jakeson21/tac5212-breakout/README.md

# tac5212_breakout
Breakout board for TAC5212
