jakeson21/tac5212-breakout/docs/Audio 2025_10_05.xlsx

Index | Manufacturer Part Number | Attrition % | Requested Quantity 1 | Pack Quantity 1 | Pack Type 1 | Digi-Key Part Number 1 | Unit Price 1 | Extended Price 1 | Minimum Order Quantity 1 | Product Notes
1 | IM69D128SV01XTMA1 |  | 2 | 2 | Cut Tape (CT) | 448-IM69D128SV01XTMA1CT-ND | 1.89000 | $3.78 | 1
2 | IM73D122V01XTMA1 |  | 1 | 1 | Cut Tape (CT) | 448-IM73D122V01XTMA1CT-ND | 2.30000 | $2.30 | 1
3 | IM72D128V01XTMA1 |  | 1 | 1 | Cut Tape (CT) | 448-IM72D128V01XTMA1CT-ND | 2.30000 | $2.30 | 1
4 | IM72D128VV01XTMA1 |  | 2 | 2 | Cut Tape (CT) | 448-IM72D128VV01XTMA1CT-ND | 2.11000 | $4.22 | 1
5 | PPPC051LGBN-RC |  | 10 | 10 | Tray | S5480-ND | 0.44300 | $4.43 | 1
6 | T491A106K016AT |  | 10 | 10 | Cut Tape (CT) | 399-8269-1-ND | 0.26200 | $2.62 | 1
7 | GRM21BZ71E106KE15L |  | 20 | 20 | Cut Tape (CT) | 490-GRM21BZ71E106KE15LCT-ND | 0.17100 | $3.42 | 1
8 | 54-00178 |  | 2 | 2 | Cut Tape (CT) | 839-54-00178CT-ND | 0.83000 | $1.66 | 1
9 | 1030 |  | 25 | 25 | Bulk | 36-1030-ND | 0.14120 | $3.53 | 1
10 | 830207659209 |  | 2 | 2 | Cut Tape (CT) | 1923-830207659209CT-ND | 1.62000 | $3.24 | 1
11 | 24114 |  | 1 | 1 | Bulk | 1568-24114-ND | 45.38000 | $45.38 | 1
12 | ANN-MB5-00 |  | 1 | 1 | Box | 672-ANN-MB5-00-ND | 34.72000 | $34.72 | 1
