jakeson21/tac5212-breakout/1030/3D/1030.stp

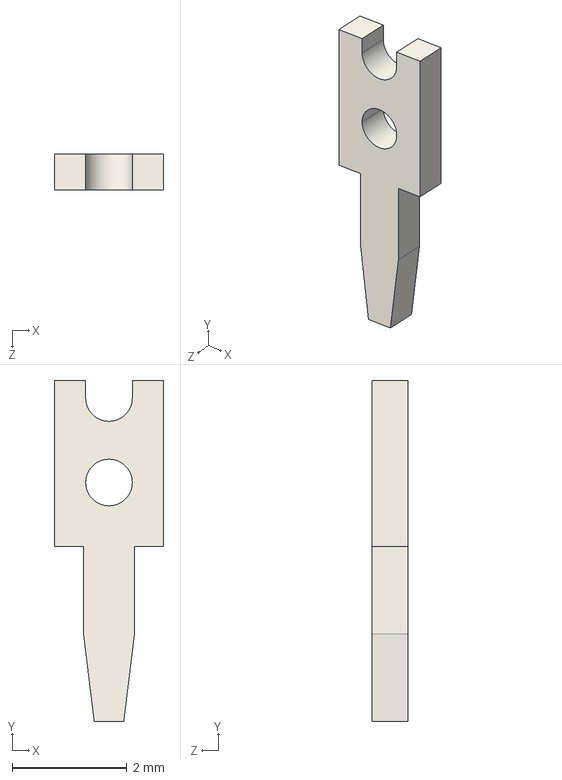
[picture p1: CAD file, 2025-10-03]
1030/3D/1030.stp
1.91 x 5.94 x 0.635 mm
