jakeson21/tac5212-breakout/KiCADv6/54-00178/54-00178.step

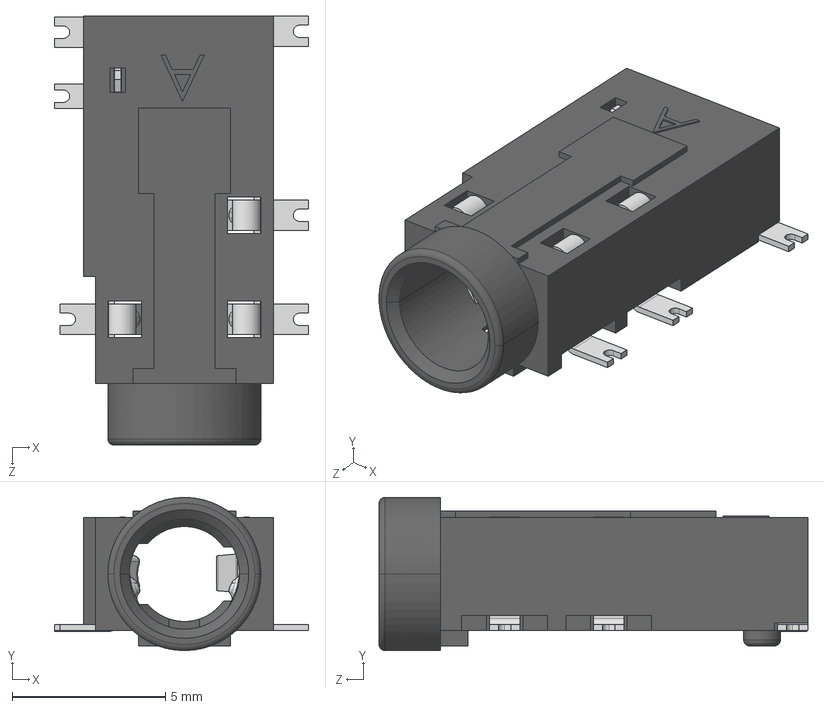
[picture p2: CAD file, 2025-10-05]
KiCADv6/54-00178/54-00178.step
8.30 x 5.00 x 14.0 mm
