jakeson21/tac5212-breakout/KiCADv6/RGE0024R.stp

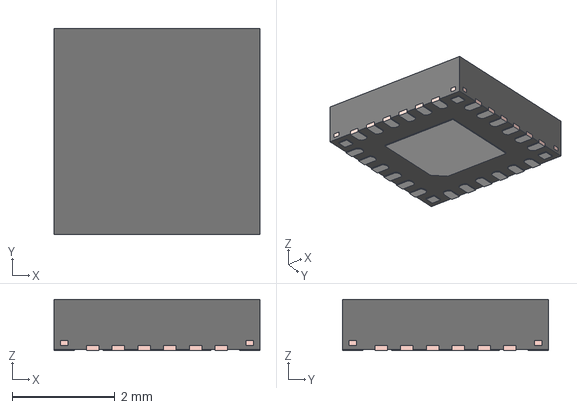
[picture p3: CAD file, 2025-10-03]
KiCADv6/RGE0024R.stp
4.00 x 4.00 x 1.00 mm
FRAME
