jakeson21/tac5212-breakout/(list of files, cad)

Other CAD files:
KiCADv6/RGE0024R.stl
