jakeson21/tac5212-breakout/tac5212.kicad_pcb

## KiCad design tac5212.kicad_pcb (2025-10-05)

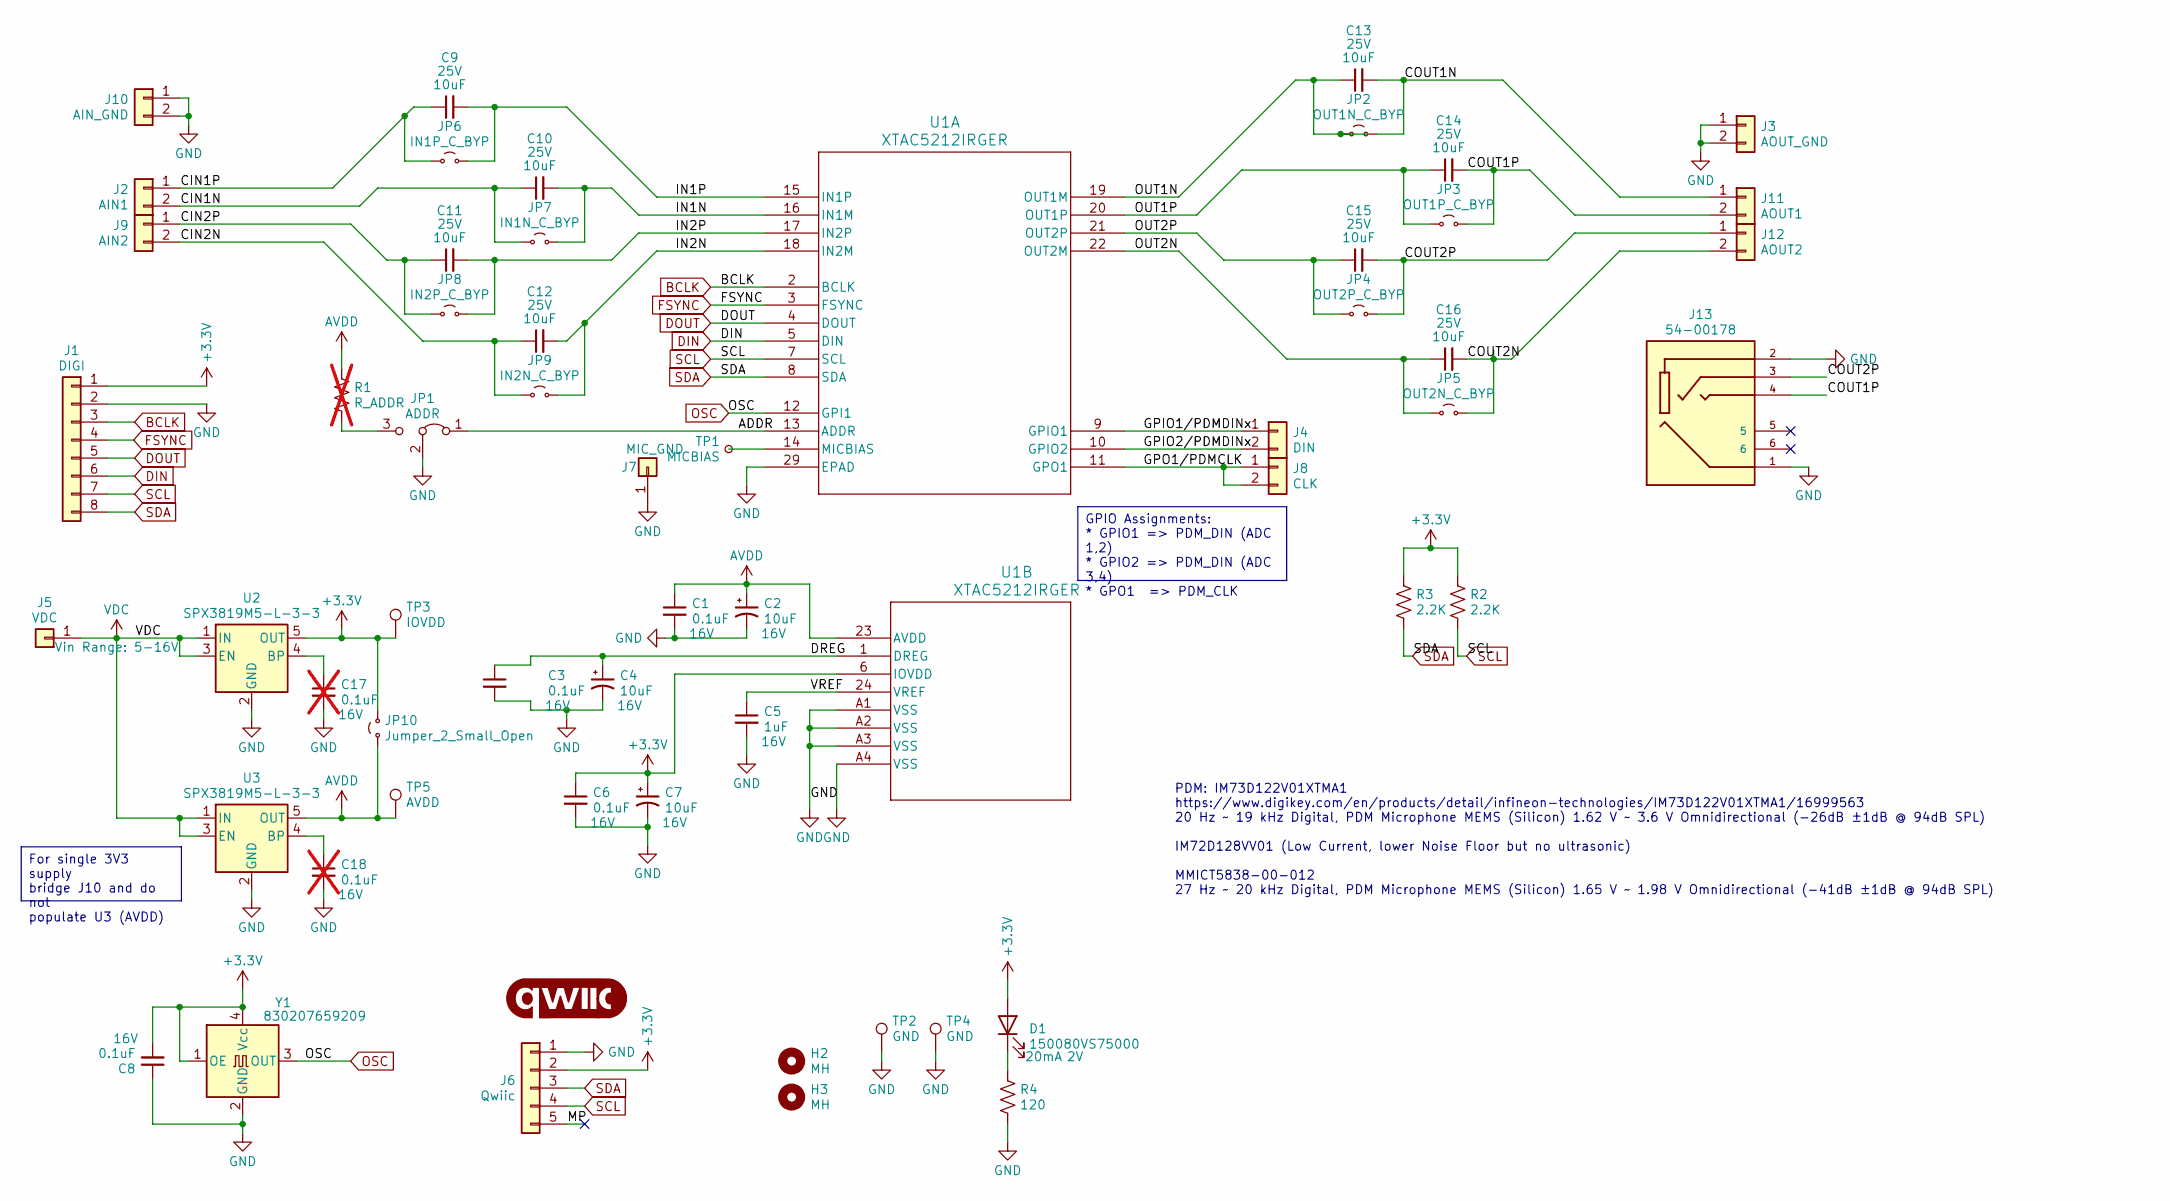
[picture p4: schematic tac5212.kicad_sch, TAC5212 Board]

Parts:
C1, C3, C6, C8: 0.1uF; C_0805_2012Metric
C2, C4, C7: 10uF; CP_EIA-3216-10_Kemet-I
C5: 1uF; C_0805_2012Metric
C9, C10, C11, C12, C13, C14, C15, C16: 10uF; C_0805_2012Metric
C17, C18: 0.1uF; C_0805_2012Metric; not fitted
D1: 150080VS75000; LED_0805_2012Metric
G1: qwiic_Logo
H2, H3: MH; MountingHole_2.2mm_M2
J1: DIGI; PinHeader_1x08_P2.54mm_Vertical
J2: AIN1; PinHeader_1x02_P2.54mm_Vertical
J3: AOUT_GND; PinHeader_1x02_P2.54mm_Vertical
J4: DIN; PinHeader_1x02_P2.54mm_Vertical
J5: VDC; PinHeader_1x01_P2.54mm_Vertical
J6: Qwiic; JST_SH_SM04B-SRSS-TB_1x04-1MP_P1.00mm_Horizontal
J7: MIC_GND; PinHeader_1x01_P2.54mm_Vertical
J8: CLK; PinHeader_1x02_P2.54mm_Vertical
J9: AIN2; PinHeader_1x02_P2.54mm_Vertical
J10: AIN_GND; PinHeader_1x02_P2.54mm_Vertical
J11: AOUT1; PinHeader_1x02_P2.54mm_Vertical
J12: AOUT2; PinHeader_1x02_P2.54mm_Vertical
J13: 54-00178; TENSILITY_54-00178; PARTREV A
JP1: ADDR; SolderJumper-3_P1.3mm_Bridged12_RoundedPad1.0x1.5mm_NumberL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
JP2: OUT1N_C_BYP; PinHeader_1x02_P2.54mm_Vertical
JP3: OUT1P_C_BYP; PinHeader_1x02_P2.54mm_Vertical
JP4: OUT2P_C_BYP; PinHeader_1x02_P2.54mm_Vertical
JP5: OUT2N_C_BYP; PinHeader_1x02_P2.54mm_Vertical
JP6: IN1P_C_BYP; PinHeader_1x02_P2.54mm_Vertical
JP7: IN1N_C_BYP; PinHeader_1x02_P2.54mm_Vertical
JP8: IN2P_C_BYP; PinHeader_1x02_P2.54mm_Vertical
JP9: IN2N_C_BYP; PinHeader_1x02_P2.54mm_Vertical
JP10: Jumper_2_Small_Open; SolderJumper-2_P1.3mm_Open_TrianglePad1.0x1.5mm
R1: R_ADDR; R_0805_2012Metric; not fitted
R2, R3: 2.2K; R_0805_2012Metric
R4: 120; R_0805_2012Metric
TP1: MICBIAS; TestPoint_THTPad_D1.5mm_Drill0.7mm
TP2, TP4: GND; 1030
TP3: IOVDD; TestPoint_THTPad_D1.0mm_Drill0.5mm
TP5: AVDD; TestPoint_THTPad_D1.0mm_Drill0.5mm
U1: XTAC5212IRGER; VQFN24_RGE_CORNERPADS_TEX
U2, U3: SPX3819M5-L-3-3; SOT-23-5
Y1: 830207659209; Oscillator_SMD_SeikoEpson_SG8002CE-4Pin_3.2x2.5mm

Connections:
+3.3V: C6.1, C7.1, C8.2, D1.2 (A), J1.1, J6.2, JP10.2 (B), R2.1, R3.1, TP3.1, U1.6 (IOVDD), U2.5 (OUT), Y1.1 (OE), Y1.4 (Vcc)
/ADDR: JP1.1 (A), U1.13 (ADDR)
/CIN1N: C10.1, J2.2, JP7.1 (A)
/CIN1P: C9.1, J2.1, JP6.1 (A)
/CIN2N: C12.1, J9.2, JP9.1 (A)
/CIN2P: C11.1, J9.1, JP8.1 (A)
/COUT1N: C13.2, J11.1, JP2.2 (B)
/COUT1P: C14.2, J11.2, J13.4, JP3.2 (B)
/COUT2N: C16.2, J12.2, JP5.2 (B)
/COUT2P: C15.2, J12.1, J13.3, JP4.2 (B)
/DREG: C3.1, C4.1, U1.1 (DREG)
/GPIO1/PDMDINx: J4.1, U1.9 (GPIO1)
/GPIO2/PDMDINx: J4.2, U1.10 (GPIO2)
/GPO1/PDMCLK: J8.1, J8.2, U1.11 (GPO1)
/IN1N: C10.2, JP7.2 (B), U1.16 (IN1M)
/IN1P: C9.2, JP6.2 (B), U1.15 (IN1P)
/IN2N: C12.2, JP9.2 (B), U1.18 (IN2M)
/IN2P: C11.2, JP8.2 (B), U1.17 (IN2P)
/OUT1N: C13.1, JP2.1 (A), U1.19 (OUT1M)
/OUT1P: C14.1, JP3.1 (A), U1.20 (OUT1P)
/OUT2N: C16.1, JP5.1 (A), U1.22 (OUT2M)
/OUT2P: C15.1, JP4.1 (A), U1.21 (OUT2P)
/VREF: C5.1, U1.24 (VREF)
AVDD: C1.1, C2.1, JP10.1 (A), R1.1, TP5.1, U1.23 (AVDD), U3.5 (OUT)
BCLK: J1.3, U1.2 (BCLK)
DIN: J1.6, U1.5 (DIN)
DOUT: J1.5, U1.4 (DOUT)
FSYNC: J1.4, U1.3 (FSYNC)
GND: C1.2, C2.2, C3.2, C4.2, C5.2, C6.2, C7.2, C8.1, C17.2, C18.2, J1.2, J3.1, J3.2, J6.1, J7.1, J10.1, J10.2, J13.1, J13.2, JP1.2 (C), R4.2, TP2.1, TP4.1, U1.29 (EPAD), U1.A1 (VSS), U1.A2 (VSS), U1.A3 (VSS), U1.A4 (VSS), U2.2 (GND), U3.2 (GND), Y1.2 (GND)
unnamed: D1.1 (K), R4.1
unnamed: JP1.3 (B), R1.2
unnamed: TP1.1, U1.14 (MICBIAS)
unnamed: C17.1, U2.4 (BP)
unnamed: C18.1, U3.4 (BP)
OSC: U1.12 (GPI1), Y1.3 (OUT)
SCL: J1.7, J6.4, R2.2, U1.7 (SCL)
SDA: J1.8, J6.3, R3.2, U1.8 (SDA)
VDC: J5.1, U2.1 (IN), U2.3 (EN), U3.1 (IN), U3.3 (EN)

Notes on the sheet:
PDM: IM73D122V01XTMA1 https://www.digikey.com/en/products/detail/infineon-technologies/IM73D122V01XTMA1/16999563 20 Hz ~ 19 kHz Digital, PDM Microphone MEMS (Silicon) 1.62 V ~ 3.6 V Omnidirectional (-26dB ±1dB @ 94dB SPL) IM72D128VV01 (Low Current, lower Noise Floor but no ultrasonic) MMICT5838-00-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
For single 3V3 supply bridge J10 and do not populate U3 (AVDD)
GPIO Assignments: * GPIO1 => PDM_DIN (ADC 1,2) * GPIO2 => PDM_DIN (ADC 3,4) * GPO1 => PDM_CLK

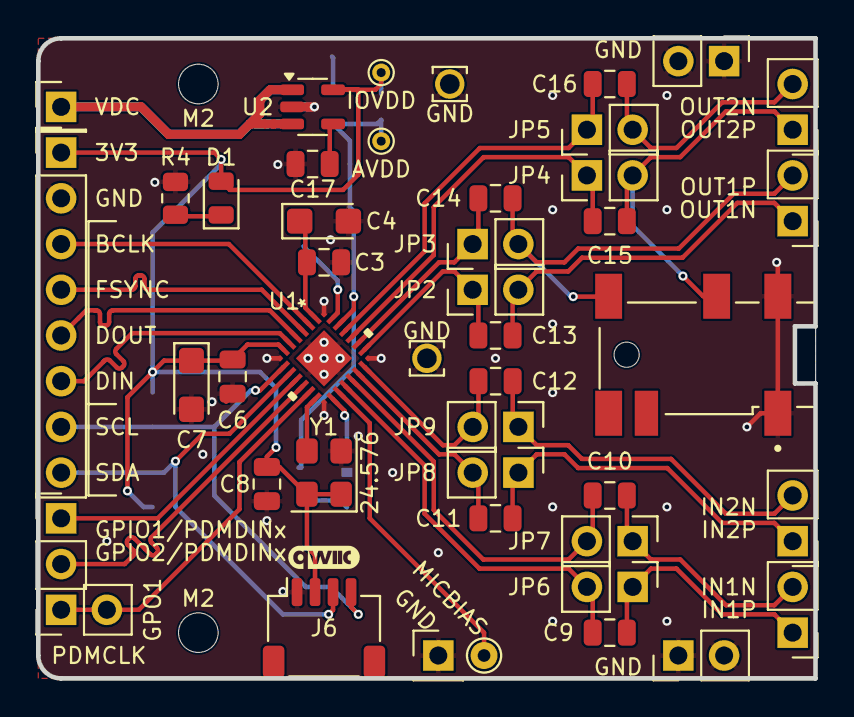
[picture p5: board tac5212.kicad_pcb from above]

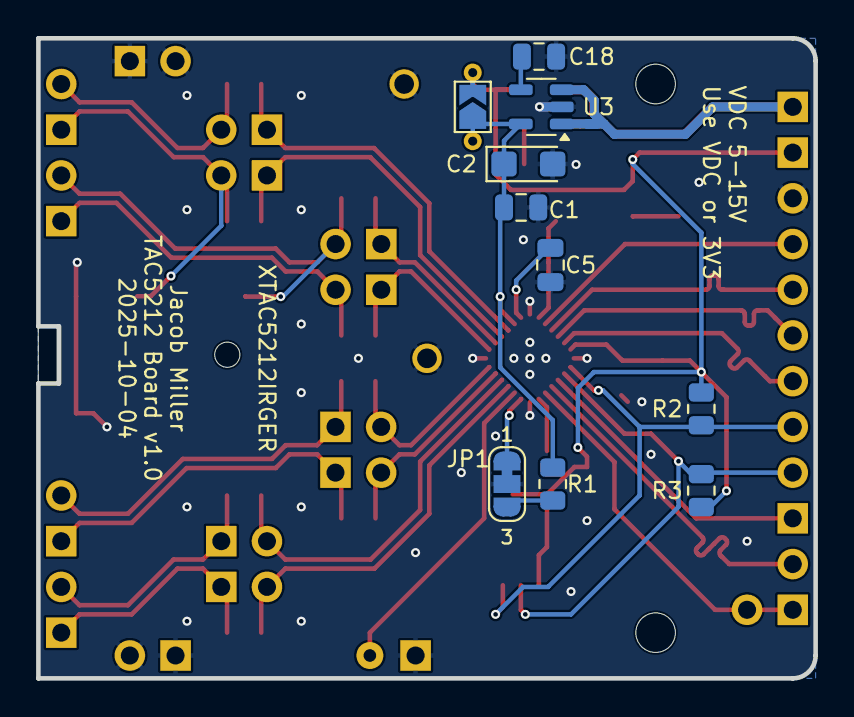
[picture p6: board tac5212.kicad_pcb from below]

Board: 4 copper layers, 43.2 x 35.6 mm, 57 parts (10 on the bottom side), 38 nets.
