jakeson21/tac5212-breakout/(commit log)

2025-10-05 v1.0 sent to fab - added AVDD supply
    [54-00178.step, tac5212.kicad_pcb, tac5212.kicad_sch]
2025-10-28 add HTML BOM
    [Audio 2025_10_05.xlsx, tac5212.kicad_sch]
